ilja-git/CoolPad/src/coolpad.scad

// CoolPad - parametric laptop cooling pad
//
// Two-part shell (top + bottom) with a fan in the middle. Air enters through
// open apertures in the side walls, crosses the plenum, and is pushed up
// through the top grille into the chamber under the laptop. That chamber is
// bounded front and rear by locating rails and open at the left and right,
// so it cannot pressurise. See SPEC.md.
//
// All dimensions in millimetres. Every variable below is top level, so it
// can be overridden from the command line:
//
//   openscad -D 'part="top"' -o top.stl src/coolpad.scad
//
// See README.md for more examples.

// ---------------------------------------------------------------------------
// What to render
// ---------------------------------------------------------------------------

part    = "assembly";   // "bottom", "top" or "assembly"
explode = 0;            // assembly only: lift the top part by this much
section = false;        // cut the model in half to show the inside
show_fan = true;        // assembly only: draw a stand-in fan (never exported)

// ---------------------------------------------------------------------------
// Material: "printed" for test parts, "aluminium" for production
// ---------------------------------------------------------------------------

material = "printed";

printed = (material == "printed");

// Clearance on the top/bottom joint, and pilot holes. A printed part
// self-taps, a machined one gets a tapped thread.
fit_gap   = printed ? 0.35 : 0.10;
pilot_m3  = printed ? 2.6  : 2.5;   // M3
pilot_m4  = printed ? 3.6  : 3.3;   // M4, fan screws

// ---------------------------------------------------------------------------
// Envelope
// ---------------------------------------------------------------------------

// Sized to an ASUS ROG Zephyrus G14, GA403 generation (2024 on): the
// laptop is approximately 311 x 220 x 16 mm.
// REMEASURE: both are ASUS's published figures, never checked on the machine.
// The tape-measure photos exist but cannot be read to better than ~5 mm.
length   = 311;   // X, across the laptop
width    = 220;   // Y, front to back
corner_r = 8;

// height is deliberately absent here: it is not a free choice but the sum
// of the stack, so it is derived from the fan below. See SPEC.md section 4.

wall    = 3;
floor_t = 3;
top_t   = 3;

// The bottom edge is rolled over so the pad is pleasant to pick up and to
// rest on a lap. Purely ergonomic; nothing depends on it.
base_round = 3;

// How far the top surface reaches past the laptop's rear foot strip before
// it stops. Enough that the foot is over solid material rather than hanging
// off an edge, and no more - the exhaust wants to get out immediately after.
shell_rear_margin = 3;

// How far the shelf's trailing edge lifts. The shelf blocks the hot air the
// laptop drops and turns it up and back, away from a lap.
shelf_lift = 4;

// The front is rolled to a much larger radius - a nose rather than an edge.
// A full half-round would be height/2, but that pulls the front face back far
// enough to undercut the front foot recesses, and moving those means moving
// the joint screws too. 9 mm reads as a nose and leaves the feet alone; the
// assert below holds the line. See SPEC.md 6.3.
front_round = 9;

// ---------------------------------------------------------------------------
// Fan: ARCTIC P14 Slim PWM PST, 140 x 140 x 16, 4-pin PWM, 12 V
// ---------------------------------------------------------------------------

fan_size        = 140;
fan_thickness   = 16;   // this alone sets the pad height - see the stack below
fan_bore        = 132;  // frame opening, kept just inside the real one
fan_screw_pitch = 125;  // ARCTIC's figure; the older 140 mm norm is 124.5
fan_boss_d      = 9;

// Axial clearance under the fan. This is its inlet - without it the fan is
// throttled against the floor. Drives the total height.
plenum_gap = 7;

// The fan is centred, as specified. The G14 draws through vents toward the
// rear of its underside, so if the grille should line up with those instead,
// shift the fan back with this rather than moving anything by hand. The
// locating rails bound how far it can go - the model asserts it.
fan_offset_y = 0;

// ---------------------------------------------------------------------------
// The laptop's feet, and the rails that trap it
// ---------------------------------------------------------------------------

// Where the laptop's own rubber feet land, MEASURED on the machine on
// 2026-09-04. See MEASUREMENTS.md. They are two long strips running nearly
// the full width, not pads, and the band between them is not symmetric.
foot_gap_rear   = 14.14;  // rear edge -> outboard edge of the rear strip
                          // REMEASURE: one read only
foot_clear_span = 166.0;  // between the strips: 118.72 + 47.30, taken in two
                          // parts because a 150 mm caliper cannot span it.
                          // REMEASURE: the two reads of the second leg
                          // differed by 0.57, and this positions everything

// The strips are tapered in section: a wide base bonded to the case,
// narrowing to a flat that bears on the table. Both ends measured, both
// strips, so nothing here is assumed any more.
foot_w_front    = 7.75;   // base width, front strip
foot_w_rear     = 7.75;   // base width, rear strip
foot_top_w      = 3.47;   // the flat that actually touches; mean of 3.42/47/52

// Height of the strips, from the thickness readings with and without them:
//   front  15.07 - 12.66 = 2.41
//   rear   17.80 - 14.64 = 3.16
// Both are differences of two ~14 mm reads, so each carries a few tenths.
// Only the larger is load-bearing - the rails have to clear it.
// REMEASURE both: differencing two ~14 mm reads to get ~2.5 mm inherits the
// error of both. Measure the table-to-underside gap at each foot directly.
laptop_foot_h_front = 2.41;
laptop_foot_h_rear  = 3.16;
laptop_foot_h_max   = max(laptop_foot_h_front, laptop_foot_h_rear);

// The underside is NOT flat. Standing on a table the rear underside is this
// much further from it than the front, because the rear foot is taller. The
// rails bear on the underside rather than on the feet, so the rear rail has
// to make up exactly this difference or it never touches. See SPEC.md 6.2.
// REMEASURE FIRST: this is a difference of two differences, so it carries
// the error of four readings, and it alone sets how much taller the rear
// rail is. Everything else here is more solid than this number.
laptop_underside_step = laptop_foot_h_rear - laptop_foot_h_front;   // 0.75

// Rails running left to right, just inboard of the laptop's feet. The laptop
// sits between them and its feet butt against their outer faces, so it
// cannot slide - which is what the old front stop ridges did, less well and
// in one direction only. The rails also hold the laptop off the top plate,
// and that gap is how the exhaust escapes sideways instead of pressurising.
//
// rail_h must exceed the laptop's foot height or the laptop rests on its own
// feet and the rails locate nothing. That height is MEASUREMENTS.md C3.
rail_h       = 5;   // common default for both rails
rail_w       = 6;
rail_x_inset = 16;

// The rails are NOT the same height, because the surface they bear on is not
// flat. The rear one is raised by the measured underside step; equal rails
// would meet the front section first and leave the rear one hanging, and the
// laptop would rest on one rail and its own rubber.
rail_h_front = rail_h;
rail_h_rear  = rail_h + laptop_underside_step;

// ---------------------------------------------------------------------------
// Side intake - open, not louvered
// ---------------------------------------------------------------------------

// The sides are open - one opening per half per side, nothing in it. Bars
// across an intake are the cheapest thing to draw and the most expensive
// thing to breathe through, so the structure went inside instead: ribs
// standing edge-on to the incoming air, where they cost almost nothing.
intake_front = 14;   // solid material kept at the front corner
band_margin  = 2;    // solid wall kept above and below the opening. Not 1:
                     // that leaves the lid's side skirt a 1 mm strip 170 mm
                     // long, which neither prints nor holds its shape

// Internal ribs. Plates lying in the XZ plane, so air entering through the
// side wall travels along their faces rather than into their edges.
// Pillars, not bars: each half carries one, and they meet at the joint to
// make a continuous post from floor to lid. They also tie back to the wall,
// which needs it now that a single opening runs nearly its whole height.
rib_n   = 3;         // per side
rib_t   = 3;         // thickness, in Y
rib_len = 12;        // how far each reaches inboard of the wall

// Solid section at the REAR of each side wall. The laptop dumps hot air off
// its back edge, and without this the pad inhales its own exhaust straight
// back through the side intake. The length is a guess until MEASUREMENTS.md
// D1-D3 land, and it is the single cheapest thing to retune afterwards.
// Solid wall kept at the rear of each side opening, measured forward from
// where the shell ends. Reduced from 45 now that the shell wall and the
// shelf physically separate the exhaust; the block used to be doing that job
// on its own. REMEASURE: still a judgement, waiting on D1-D3.
intake_rear_block = 25;

// ---------------------------------------------------------------------------
// Joint, grille, feet
// ---------------------------------------------------------------------------

boss_d      = 8;      // top-part screw bosses
boss_socket = 1.5;    // depth of the locating socket in the floor
screw_head_d = 6.5;   // counterbore in the underside
screw_head_h = 2.4;

grille_bar  = 2.5;
grille_gap  = 7;
grille_hub  = 20;
grille_arms = 4;      // bars through the centre; 4 bars = 8 arms

foot_d = 16;          // recesses for stick-on rubber feet
foot_t = 1;

// Feet sit at the corners for stability; the joint screws are inboard of
// them so a stuck-on foot never covers a screw head.
joint_inset = 28;
foot_inset  = 18;     // moved out from 16 to clear the rolled front

$fa = 2;
$fs = 0.6;

// ---------------------------------------------------------------------------
// Derived
// ---------------------------------------------------------------------------

min_height = floor_t + plenum_gap + fan_thickness + top_t;

// The fan's top face has to land flush under the top plate or it exhausts
// straight back into its own plenum, so the height follows the fan rather
// than the other way round. Fit a thicker fan and the pad grows by itself.
// -D height=... still overrides, and the assert below still catches a
// height that would crush the fan.
height     = min_height;

split_z    = height / 2;          // top/bottom joint
fan_z      = floor_t + plenum_gap; // underside of the fan
cx         = length / 2;
cy         = width / 2;
fan_cy     = cy + fan_offset_y;   // fan/grille centre

// ONE opening per side, not one per half. It is defined once, spanning the
// joint, and each part clips its own half out of it - so assembled, the side
// has a single continuous hole with no waist where the parts meet.
open_band = [floor_t + band_margin, height - top_t - band_margin];
open_h    = open_band[1] - open_band[0];

// Inner faces of the locating rails: the clear span the grille must fit in.
// The shell - walls, cavity, lid, rails - stops just behind the laptop's rear
// foot strip. Everything behind that is floor only: the shelf, over which the
// laptop's rear overhangs and dumps its hot air into open space.
shell_rear = width - foot_gap_rear + shell_rear_margin;

// Inboard edges of the laptop's foot strips, i.e. the clear band the rails
// and grille have to live inside. Derived from the measurements above rather
// than set, so a corrected measurement moves everything at once.
foot_band_rear  = foot_gap_rear + foot_w_rear;               // 21.94
foot_band_front = width - foot_band_rear - foot_clear_span;  // 32.06

// Inner faces of the rails: the clear span the grille must fit in.
rail_front = foot_band_front + rail_w;
rail_rear  = width - foot_band_rear - rail_w;

// One opening per half, per side. No posts: the ribs inside carry the wall.
intake_y0   = intake_front;
intake_y1   = shell_rear - intake_rear_block;
intake_span = intake_y1 - intake_y0;

function rib_positions() =
    [for (i = [1 : rib_n]) intake_y0 + i * intake_span / (rib_n + 1)];

// Free area of the intake, against the fan's bore. The intake is the
// restriction in this design, so this number is worth watching.
function stadium_area(w, h) = max(w - h, 0) * h + PI * pow(h / 2, 2);
// Two sides, one opening each, less what the pillars stand in.
intake_area = 2 * stadium_area(intake_span, open_h)
              - 2 * rib_n * rib_t * open_h;
bore_area   = PI * pow(fan_bore / 2, 2);

echo(str("intake free area = ", round(intake_area), " mm2 = ",
         round(100 * intake_area / bore_area), "% of the fan bore, ",
         "in 2 open sides"));

assert(height >= min_height,
       str("height=", height, " is too small: floor_t + plenum_gap + ",
           "fan_thickness + top_t = ", min_height));
assert(fan_size + 4 <= length - 2 * wall
       && fan_cy - fan_size / 2 - 2 >= wall
       && fan_cy + fan_size / 2 + 2 <= width - wall,
       "fan does not fit inside the walls at this size/offset");
assert(split_z > floor_t && split_z < height - top_t,
       "split_z falls outside the cavity");
assert(part == "bottom" || part == "top" || part == "assembly",
       str("unknown part: ", part));

// A foot must not land on a screw head, or the screw is trapped under it.
assert(sqrt(2) * abs(joint_inset - foot_inset) > foot_d / 2 + screw_head_d / 2,
       "foot recesses overlap the joint screw heads");

// Joint bosses must clear the fan bosses.
assert(min([for (j = joint_points(), f = fan_points())
            norm([j[0] - f[0], j[1] - f[1]])]) > (boss_d + fan_boss_d) / 2,
       "joint bosses collide with fan bosses");

// The grille has to sit between the rails, not under one of them - and by
// extension not under a laptop foot. This is the tightest constraint on
// fan_offset_y by a long way.
assert(foot_band_front > 0 && foot_band_rear > 0,
       "the measured foot band does not fit inside the pad's depth");
// The lid has to reach past the rear foot strip, or the strip hangs over an
// edge; and it has to stop short of the rear, or there is no shelf.
assert(shell_rear > width - foot_gap_rear,
       "the lid stops short of the laptop's rear foot strip");
assert(shell_rear < width - wall,
       "the lid runs to the back; there is no room left for the shelf");
assert(rail_rear + rail_w < shell_rear,
       "the rear rail falls outside the lid");
assert(fan_bore <= rail_rear - rail_front,
       str("grille (", fan_bore, " mm) will not fit between the rails (",
           rail_rear - rail_front, " mm)"));
assert(fan_cy - fan_bore / 2 >= rail_front
       && fan_cy + fan_bore / 2 <= rail_rear,
       "fan_offset_y pushes the grille under a locating rail");

// A rail no taller than the laptop's own feet locates nothing: the laptop
// would come to rest on its own rubber and the rails would never touch it.
assert(min(rail_h_front, rail_h_rear) > laptop_foot_h_max,
       str("rails (", rail_h_front, "/", rail_h_rear, " mm) do not clear the ",
           "laptop's feet (up to ", laptop_foot_h_max, " mm)"));
assert(min(rail_h_front, rail_h_rear) > rail_w / 2,
       "rail height too small for its rounded top");

// The openings must stay openings rather than collapsing back into slots.
assert(intake_span >= 4 * open_h,
       str("side openings have collapsed to ", intake_span, " mm: ",
           "intake_front + intake_rear_block leave too little wall"));

// The rolled front must not undercut the front foot recesses, or a stuck-on
// foot hangs over the edge.
assert(front_round + foot_d / 2 <= foot_inset,
       str("front_round=", front_round, " undercuts the front feet; ",
           "raise foot_inset above ", front_round + foot_d / 2));
assert(front_round < height / 2 + 0.001,
       "front_round cannot exceed half the height");

// ---------------------------------------------------------------------------
// Helpers
// ---------------------------------------------------------------------------

// Rounded rectangle from (0,0) to (l,w).
module rrect(l, w, r, h) {
    hull() for (x = [r, l - r], y = [r, w - r])
        translate([x, y, 0]) cylinder(r = r, h = h);
}

// The same, with the bottom edge rolled over by f. The solid stays convex,
// so a single hull() through the profile is exact rather than an
// approximation, and it costs one CGAL union instead of a minkowski.
module rrect_round_base(l, w, r, h, f) {
    steps = 6;
    hull() {
        translate([0, 0, f]) rrect(l, w, r, h - f);
        for (i = [0 : steps]) {
            a  = i * 90 / steps;
            di = f - f * sin(a);      // f -> 0
            dz = f - f * cos(a);      // 0 -> f
            translate([di, di, dz])
                rrect(l - 2 * di, w - 2 * di, max(r - di, 0.5), 0.01);
        }
    }
}

// The shell stops at shell_rear, square across the back, because the shelf
// carries straight on behind it and a rounded end would step at the corners.
module shell_clip(h) {
    translate([-1, -1, -1]) cube([length + 2, shell_rear + 1, h + 2]);
}

// The floor beyond the shell: a plate of constant thickness tilting up to
// shelf_lift at the rear edge. Built as the hull of two thin slabs, which is
// exactly that solid, and started 2 mm inside the shell so the union
// overlaps rather than meeting it face to face.
module shelf() {
    intersection() {
        hull() {
            translate([0, shell_rear - 2, 0])   cube([length, 0.01, floor_t]);
            translate([0, width - 0.01, shelf_lift]) cube([length, 0.01, floor_t]);
        }
        rrect_round_base(length, width, corner_r, split_z + shelf_lift + 10,
                         base_round);
    }
}

module annulus(ro, ri, h) {
    difference() {
        cylinder(r = ro, h = h);
        translate([0, 0, -1]) cylinder(r = ri, h = h + 2);
    }
}

// Horizontal stadium, centred on the origin in Y and Z, extruded +X by d.
// Rounded ends so an opening this large is not a stress riser in a 3 mm wall.
module aperture(w, h, d) {
    hull() for (y = [-1, 1] * max(w - h, 0) / 2)
        translate([0, y, 0]) rotate([0, 90, 0]) cylinder(d = h, h = d);
}

// The intake: one oval per side, cut in full from whichever part is asking.
// Each part exists over only half the height, so each takes half the oval and
// the assembled pair leaves one continuous hole. Left and right only - the
// front is solid, and so is the rear, which the shelf works behind.
module intake_openings() {
    yc = (intake_y0 + intake_y1) / 2;
    zc = (open_band[0] + open_band[1]) / 2;
    translate([-1, yc, zc])                aperture(intake_span, open_h, wall + 2);
    translate([length - wall - 1, yc, zc]) aperture(intake_span, open_h, wall + 2);
}

// Ribs behind the opening, carrying the wall now that nothing spans it.
// Edge-on to the incoming air, and overlapping the wall so the union is
// never tangent to it.
module intake_ribs(z0, z1) {
    for (y = rib_positions())
        for (x = [wall - 0.05, length - wall - rib_len + 0.05])
            translate([x, y - rib_t / 2, z0])
                cube([rib_len, rib_t, z1 - z0]);
}

// Everything at or behind the rolled front. Intersecting a part with this
// turns its front edge into a nose without touching anything else - the same
// clip serves both halves, so the two meet without a step at the joint.
//
// The profile is a flat face between two rolls, not a single bulge: rolled
// away at the bottom so it does not dig into a lap, and at the top so the
// laptop's front edge has nothing sharp under it.
module nose_clip() {
    r = front_round;
    union() {
        // everything behind the nose
        translate([-1, r, -1])
            cube([length + 2, width - r + 1, height + 22]);
        // the flat face between the rolls
        translate([-1, 0, r])
            cube([length + 2, r, height - 2 * r]);
        // the two rolls
        for (z = [r, height - r])
            translate([-1, r, z])
                rotate([0, 90, 0]) cylinder(r = r, h = length + 2);
    }
}

// Joint screw positions, inboard of the feet.
function joint_points() =
    let (m = joint_inset)
    [[m, m], [length - m, m], [m, width - m], [length - m, width - m]];

// Foot recesses, out at the corners.
function foot_points() =
    let (m = foot_inset)
    [[m, m], [length - m, m], [m, width - m], [length - m, width - m]];

function fan_points() =
    [for (dx = [-1, 1], dy = [-1, 1])
        [cx + dx * fan_screw_pitch / 2, fan_cy + dy * fan_screw_pitch / 2]];

// ---------------------------------------------------------------------------
// Bottom: tray, solid floor, fan mounting, side intake
// ---------------------------------------------------------------------------

module bottom() {
  intersection() {
    nose_clip();
    difference() {
        union() {
            difference() {
                union() {
                    intersection() {
                        rrect_round_base(length, width, corner_r, split_z,
                                         base_round);
                        shell_clip(split_z);
                    }
                    shelf();
                }

                // cavity, open at the top, closed at the back by the wall
                // the shelf hangs off
                translate([wall, wall, floor_t])
                    rrect(length - 2 * wall, shell_rear - 2 * wall,
                          max(corner_r - wall, 0.5), split_z);

                intake_openings();
            }

            // ribs carrying the side walls, now that nothing spans the
            // openings from outside
            intake_ribs(floor_t, split_z);

            // fan bosses, floor up to the underside of the fan
            for (p = fan_points())
                translate([p[0], p[1], floor_t])
                    cylinder(d = fan_boss_d, h = plenum_gap);
        }

        // fan screws
        for (p = fan_points())
            translate([p[0], p[1], floor_t - 1])
                cylinder(d = pilot_m4, h = plenum_gap + 2);

        // joint screws: through the floor, counterbored underneath so the
        // heads sit below the desk-facing surface
        for (p = joint_points()) {
            translate([p[0], p[1], -1])
                cylinder(d = 3.4, h = floor_t + 2);
            translate([p[0], p[1], -0.01])
                cylinder(d = screw_head_d, h = screw_head_h);
            // socket that locates the top part's boss
            translate([p[0], p[1], floor_t - boss_socket])
                cylinder(d = boss_d + 2 * fit_gap, h = boss_socket + 0.01);
        }

        // recesses for stick-on rubber feet
        for (p = foot_points())
            translate([p[0], p[1], -0.01]) cylinder(d = foot_d, h = foot_t);
    }
  }
}

// ---------------------------------------------------------------------------
// Top: lid, exhaust grille, locating rails, side intake
// ---------------------------------------------------------------------------

// The bars that stay: centre hub, concentric rings, radial arms.
module grille_bars() {
    o = 0.05;
    translate([0, 0, -o]) cylinder(d = grille_hub, h = top_t + 2 * o);
    for (r = [grille_hub / 2 + grille_gap : grille_bar + grille_gap
              : fan_bore / 2])
        translate([0, 0, -o]) annulus(r + grille_bar, r, top_t + 2 * o);
    for (i = [0 : grille_arms - 1])
        rotate([0, 0, i * 180 / grille_arms])
            translate([-fan_bore / 2, -grille_bar / 2, -o])
                cube([fan_bore, grille_bar, top_t + 2 * o]);
}

// The air gaps, i.e. everything inside the bore that is not a bar. Cutting
// these out of the plate keeps the top part a single solid - adding a
// separately built grille back into a bored hole leaves coincident faces
// and exports non-manifold.
module grille_openings() {
    intersection() {
        translate([0, 0, -0.01]) cylinder(d = fan_bore, h = top_t + 0.02);
        difference() {
            translate([0, 0, -0.02])
                cylinder(d = fan_bore + 2, h = top_t + 0.04);
            grille_bars();
        }
    }
}

// Two rails, one just inboard of each of the laptop's foot strips. Rounded
// on top, drafted at the sides, and buried 1 mm in the plate so the union
// overlaps rather than sitting tangent to it.
module locating_rails() {
    x0    = rail_x_inset;
    len_x = length - 2 * rail_x_inset;
    for (r = [[foot_band_front, rail_h_front], [rail_rear, rail_h_rear]])
        hull() {
            translate([x0, r[0] + rail_w / 2, height + r[1] - rail_w / 2])
                rotate([0, 90, 0]) cylinder(d = rail_w, h = len_x);
            translate([x0, r[0], height - 1])
                cube([len_x, rail_w, 0.01]);
        }
}

module top_part() {
    plate_z = height - top_t;

  intersection() {
    nose_clip();
    difference() {
        union() {
            // skirt + plate, stopping where the shell does
            difference() {
                intersection() {
                    translate([0, 0, split_z])
                        rrect(length, width, corner_r, height - split_z);
                    shell_clip(height);
                }
                translate([wall, wall, split_z - 1])
                    rrect(length - 2 * wall, shell_rear - 2 * wall,
                          max(corner_r - wall, 0.5),
                          plate_z - split_z + 1);
            }

            // screw bosses, hanging from the plate down onto the floor
            for (p = joint_points())
                translate([p[0], p[1], floor_t - boss_socket])
                    cylinder(d = boss_d, h = height - floor_t + boss_socket);

            intake_ribs(split_z, plate_z);
            locating_rails();
        }

        // exhaust grille
        translate([cx, fan_cy, plate_z]) grille_openings();

        intake_openings();

        for (p = joint_points())
            translate([p[0], p[1], floor_t - boss_socket - 1])
                cylinder(d = pilot_m3, h = plate_z - floor_t + boss_socket + 1);
    }
  }
}

// ---------------------------------------------------------------------------
// Fan stand-in - preview only, never part of an exported part
// ---------------------------------------------------------------------------

module fan_mock() {
    translate([cx - fan_size / 2, fan_cy - fan_size / 2, fan_z]) {
        difference() {
            rrect(fan_size, fan_size, 5, fan_thickness);
            translate([fan_size / 2, fan_size / 2, -1])
                cylinder(d = fan_bore, h = fan_thickness + 2);
            for (dx = [-1, 1], dy = [-1, 1])
                translate([fan_size / 2 + dx * fan_screw_pitch / 2,
                           fan_size / 2 + dy * fan_screw_pitch / 2, -1])
                    cylinder(d = 4.5, h = fan_thickness + 2);
        }
        translate([fan_size / 2, fan_size / 2, 0]) {
            cylinder(d = 40, h = fan_thickness);
            for (i = [0 : 6])
                rotate([0, 0, i * 360 / 7])
                    translate([0, 0, fan_thickness / 2])
                        rotate([20, 0, 0])
                            translate([18, 0, 0])
                                cube([36, 1.2, 11], center = true);
        }
    }
}

// ---------------------------------------------------------------------------
// Output
// ---------------------------------------------------------------------------

module model() {
    if (part == "bottom") bottom();
    else if (part == "top") top_part();
    else {
        bottom();
        translate([0, 0, explode]) top_part();
        if (show_fan) translate([0, 0, explode / 2]) fan_mock();
    }
}

if (section) {
    // Half cut on Y, keeping the far half, so the cut face points at the
    // camera in a front view. This is the only view that shows the plenum
    // gap under the fan, which is the dimension the design turns on.
    difference() {
        model();
        translate([-1, -1, -1])
            // must clear the rails too, or their tops survive the cut as
            // detached slivers
            cube([length + 2, cy + 1,
                  height + explode + max(rail_h_front, rail_h_rear) + 3]);
    }
} else {
    model();
}
