ilja-git/CoolPad/(commit log)

2026-08-29 Add parametric base model and CI rendering to STL + PNG
    Set up the repo for OpenSCAD models rendered by CI, since the models
    cannot be built or previewed locally from a phone.
    - src/coolpad.scad: rectangular base with length/width/height as
    top-level variables so they are overridable with -D. The geometry is
    a placeholder until the real part is decided.
    - .github/workflows/render.yml: on push/PR, render the STL and a PNG
    preview and upload both as an artifact. PNG uses --render so the
    image matches the exported geometry, and runs under xvfb since the
    runner is headless. workflow_dispatch takes optional dimension
    overrides, validated as numeric before reaching the command line.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
    [coolpad.scad]
2026-08-29 Replace placeholder cube with the two-part cooling pad
    Spec in SPEC.md, model built to it. The pad is a closed shell in two
    parts, hollow inside, with a 120 mm fan in the middle: air enters through
    louvers in the left, right and front walls, crosses the plenum, and is
    pushed up through the top grille. The floor is solid - no bottom intake.
    The driving dimension is that an axial fan draws air from below, so it
    needs clearance underneath or it is throttled against the floor. That
    plenum gap sets the height budget: floor + gap + fan + plate = 28, not the
    placeholder 20. The model asserts this rather than silently producing a
    pad that crushes the fan, and asserts the other constraints that are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
    [coolpad.scad]
2026-08-29 Intake on left/right walls only; size the pad to a Zephyrus G14
    Two corrections from review.
    Intake is the left and right walls only. The front wall is now solid, like
    the rear. Losing a third of the wall costs open area, so the louvers are
    opened from 4.5 to 6 mm slots on the same 9 mm pitch, leaving a 3 mm land.
    The model now computes the louver free area and echoes it, and CI carries
    it into the run summary: 4072 mm2, 41% of the fan bore. The intake, not
    the grille, is what limits flow in this design, so it is worth watching on
    every render.
    Footprint is now the laptop's rather than the print bed's: 312 x 227, an
    assumed GA402-generation G14. Generations differ by up to 13 mm, so the
    as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
    [coolpad.scad]
2026-08-29 Retarget the pad to the GA403 G14: 311 x 220
    Confirmed generation, so the footprint is no longer an assumed middle
    value. GA403 (2024 on) is approximately 311 x 220 x 16 mm.
    The 7 mm lost off the depth shortens both side walls, which costs a little
    intake: the model now reports 3887 mm2, 39% of the fan bore, down from
    41%. Still the limiting restriction in the design.
    Print bed is expected to take a 311 x 220 part, so the parts stay
    unsplit. SPEC.md records that as an assumption to confirm against the
    real machine rather than a settled fact, with the bolted lap joint noted
    as the fallback if it does not hold.
    Claude-Session: https://cl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
    [coolpad.scad]
2026-08-29 Emit USDZ so the model can be viewed on the phone
    iOS will not preview an STL, but it opens USDZ natively in Quick Look with
    no app installed, including an AR mode. That makes it the only output in
    this pipeline that can actually be turned around on a phone, so CI now
    builds one per part plus one of the assembled product.
    Two things decide whether the AR view is any use, and both are enforced:
    - Real-world scale. The model is in millimetres, so the stage records
    metersPerUnit 0.001. The pad then appears at true size in AR, which is
    what makes it possible to hold the phone over the laptop and see whether
    it fits.
    - Up axis. The model is Z-up and Quick Look expects Y-up. The rotation i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
2026-09-04 Retarget to the ARCTIC P14 Slim and derive the height
    The fan is settled: ARCTIC P14 Slim PWM PST, 140 x 140 x 16, mounting
    holes on a 125 mm pitch, 12 V PWM. That is 20 mm wider and 1 mm thicker
    than the 120 x 15 placeholder, so the pad grows to 29 mm.
    Rather than edit the height by hand to match, compute it. The fan's top
    face has to meet the underside of the top plate or it exhausts back into
    its own plenum, so height was never a free variable - it just looked like
    one. It is now floor_t + plenum_gap + fan_thickness + top_t outright, and
    -D fan_thickness=25 resizes the pad on its own. -D height= still
    overrides, and the assert still catches a height that would crush the fan.
    Two things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
    [coolpad.scad]
2026-09-04 Build every artifact locally with tools/build.sh
    Everything was reachable only through CI, which meant a round trip to
    GitHub to see the effect of any change. tools/build.sh now produces the
    same ten artifacts on a workstation.
    The workflow calls the same script rather than keeping its own copy, so
    the two cannot drift. That matters because the parts of the build that
    are easy to get wrong are exactly the parts nobody re-derives: the
    manifold gate that exists because OpenSCAD exits 0 on broken geometry,
    the tuned camera angles, and the USDZ checks. It picks up xvfb only when
    there is no display, and says what to install when a dependency is
    missing rather than failing halfway through.
    The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
2026-09-04 Record what needs measuring, and bound the fan by the feet
    MEASUREMENTS.md collects the numbers the design is now waiting on, in the
    form of a table to fill in and commit. It leads with the method that needs
    no tools: photograph the underside straight down with a bank card in
    frame. Every bank card is ISO/IEC 7810 ID-1, 85.60 x 53.98 mm, which makes
    it a scale bar good to about a millimetre - enough for everything except
    the foot heights.
    It also adds a section that was missing from the spec entirely:
    recirculation. The pad breathes through its left and right walls, and if
    the laptop exhausts low on those same sides then the pad drinks its own
    hot air. Cheap to fix while the louvers are par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
    [coolpad.scad]
2026-09-04 Rule out running the 12 V fan on 5 V, with the reason
    The fan starts fine at 5 V - ARCTIC publish 3.9 V for the P12 PWM and
    3.3 V for the P12 Pro - so the obvious answer is that it "just runs
    slower". It does not, not for this pad.
    Airflow runs with rpm but static pressure runs with rpm squared, so 5/12
    of the voltage costs 60% of the flow and 83% of the pressure. A fan in
    free air would shrug that off. This one has an intake worth 30% of its
    bore, so static pressure is precisely what it spends its life on, and
    losing five-sixths of it drops delivered airflow by much more than the
    60% the flow figure suggests.
    Recommends a 5 V to 12 V boost converter over a PD trigger: it needs no
    negotiat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
2026-09-04 Rev 0.5: the pad becomes a chamber, and the sides open up
    Reworks the top surface around how the laptop actually sits. Two rails run
    left to right just inboard of the laptop's own feet, and the laptop is
    trapped between them. They locate it in both directions, which the old
    front-only stop ridges could not; they hold it clear of the top plate; and
    they separate cool supply from the hot region at the rear. The stop ridges
    are gone.
    The chamber the rails create is deliberately open at the left and right.
    The fan can then never pressurise it - surplus air spills out the sides
    rather than stalling the fan when the laptop's vents cannot swallow
    everything. That escaping air is somewhat warm and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
    [coolpad.scad]
2026-09-04 Render previews in greyscale, and fix the USB-C chain
    The previews were teal-and-yellow, which reads as cheap and buries the
    geometry under colour. They are now grey on white, with cut faces a darker
    grey than original surfaces so a section is still readable at a glance.
    Getting there took more than a flag. None of OpenSCAD's eleven built-in
    schemes is greyscale - "Monotone" is a single flat yellow and "Metallic" is
    magenta on lavender - and 2021.01 ignores color() when rendering with
    --render, so colouring the model does nothing. It also has no user path for
    colour schemes: ~/.local/share, ~/.OpenSCAD and ~/Documents were all tried
    and none is scanned. The scheme has to sit beside the ship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
2026-09-04 Take in the G14 photos, and ignore the scan folder
    The scan and measurement photos live in scan/, which is gitignored: they
    are large binaries and not source. MEASUREMENTS.md is where numbers taken
    from them belong.
    Records what the photographs already settle. The bottom intake is one
    large perforated field rather than two openings, so a single circular
    grille is the right shape and B5 is answered. It covers most of the width
    and a broad band of the rear half's depth, so a 132 mm grille overlaps it
    heavily before any offset at all - the fan-alignment risk is much smaller
    than feared. There are two long rubber foot strips, front and rear, near
    full width, which is exactly what the locating r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
2026-09-04 Position the top surface from the measured feet, not a guess
    The laptop's feet were measured on 2026-09-04 and the guess they replace
    was wrong in a way that mattered.
    The clear band between the two foot strips is 166.0 mm, not the 180 mm
    assumed. It was taken in two parts - 118.72 mm from the rear strip to the
    step in the bottom panel, then 47.30 mm from that step to the front strip -
    because a 150 mm caliper cannot span it in one go. The second leg was
    measured twice, 47.87 and 47.30, and the smaller is used deliberately: too
    small and the rails sit slightly inboard of the feet, which costs nothing,
    while too large puts them under a foot, which is the failure the rails
    exist to prevent.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
    [coolpad.scad]
2026-09-04 Log the second batch of readings, unlabelled
    Twelve more caliper photos, filed by reading. They cluster - 3.42/3.47/3.52,
    7.75/7.75, 12.43/12.66, 14.00/14.59 - and a repeated reading is a
    deliberate one, so the clusters are recorded as hypotheses rather than
    noise.
    Two of them would close both remaining assumptions if confirmed: a foot
    height near 3.5 mm clears rail_h at 5 mm and the rev 0.5 concept holds
    unchanged, and a rear strip at 7.75 against the assumed 7.80 would mean
    foot_clear_span stands as it is.
    Nothing is in the model. Two plausible clusters are not a measurement, and
    a wrong rail_h is precisely the error that defeats the rails without
    looking like anything is wrong.
    Co-Auth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
2026-09-04 Resolve the feet, and split the rails that the step now divides
    The second batch is labelled, and the feet turn out to be tapered: a
    7.75 mm base bonded to the case narrowing to a 3.47 mm flat that bears.
    Both strips measured at both ends, so the rear strip stops being an
    assumption and foot_clear_span stands as it is.
    Foot height could only be had by differencing two ~14 mm thickness
    readings, so it inherits the error of both and lands anywhere in 2.4 to
    3.8 mm rather than on a number. Only the upper bound is load-bearing, and
    rail_h at 5 mm clears all of it - so the rev 0.5 concept holds and no
    geometry had to move. An assert now enforces that: rail_h_rear=3 is
    rejected against the 3.8 mm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
    [coolpad.scad]
2026-09-04 Raise the rear rail 0.75 mm, and mark what is provisional
    17.80 confirmed - the middle segment makes it an 8. With your pairings the
    feet come out at 2.41 mm front and 3.16 mm rear, so standing on a table the
    rear underside sits 0.75 mm further from it than the front.
    The rails bear on the underside, not on the feet, so that difference is
    theirs to make up. rail_h_rear is now rail_h + laptop_underside_step, and
    the step is derived from the two foot heights rather than typed in, so
    correcting either moves the rail. Equal rails would have met the front
    section first and left the rear one hanging, and the laptop would have
    rested on one rail plus its own rubber - looking fine and locating noth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
    [coolpad.scad]
2026-09-04 Open the sides properly, and roll the front into a nose
    From docs/idea-2. Both sketches are filed there; unlike the photos they are
    not to scale and carry intent rather than dimensions.
    The side intakes lose their posts. Bars across an intake are the cheapest
    thing to draw and the most expensive thing to breathe through, so each half
    of each side is now one clear opening and the structure moved inside: three
    ribs per side per half, lying in the XZ plane so air entering the wall
    travels along their faces instead of into their edges. They cost about 6% of
    the opening where the posts cost a third. Intake goes 37% -> 42% of the bore.
    The front is rolled into a nose - a flat face between two ro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
    [coolpad.scad]
2026-09-04 One oval per side, a shelf behind the lid, and taggable releases
    The pad is no longer bound to the laptop's footprint, so the shape follows
    what the air needs.
    The lid now stops 3 mm past the laptop's rear foot strip, at y=208.86, and
    the floor carries straight on to 220. Behind the lid the laptop's rear
    overhangs open space, so the hot air it drops has somewhere to go; the shelf
    under it tilts up 4 mm at the trailing edge to turn that air back and away
    from a lap rather than down onto one. intake_rear_block drops 45 -> 25,
    because the shell wall and the shelf now separate the exhaust physically -
    the block had been doing that job alone.
    The side intake becomes ONE oval per side rather tha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
    [coolpad.scad]
